CarlDominicA/247-575-SH-PLANIFICATION-DE-PROJET-BUS-CAN/README.md

## Ce projet est un module CAN pour une voiture de course de type électrique

#### ci-dessous, une affiche pour le présentoir

ImageStaticAffiche_CapteurCAN
