CarlDominicA/247-575-SH-PLANIFICATION-DE-PROJET-BUS-CAN/Session_H24/README.md

**Regroupe les travaux fait pendant la session d'hivers de 2024**

# Logiciel :
**contient tous les éléments logiciels/programmations de ce projet**

-envoie de trame CAN

-conversion analogique

# Matériel : 
**contient tous les éléments physique de ce projet.**

-PCB

-Liste capteurs

-Liste pièces
