CarlDominicA/247-575-SH-PLANIFICATION-DE-PROJET-BUS-CAN/Session_A23/README.md

**Regroupe les travaux fait pendant la session d'automne de 2023**

# Logiciel :
**contient tous les éléments logiciels/programmations de ce projet**

-envoie de trame CAN

-réception de trame CAN

-apperçu de la construction d'une trame

# Matériel : 
**contient tous les éléments physique de ce projet.**

-Prototype
