CarlDominicA/247-575-SH-PLANIFICATION-DE-PROJET-BUS-CAN/Session_H24/Logiciel/README.md

## ESP32Arduino
code : arduino (c++)
framework : platformino
description : envoie can sur en c++

## MCP3221
code : arduino (c++)
framework : platformino
description : conversion analogique à nunérique
