CarlDominicA/247-575-SH-PLANIFICATION-DE-PROJET-BUS-CAN/Session_H24/Matériel/README.md

## Matériaux pour le produit final

##### Boitier 3D (fait sur Tinkercad)

##### Capteurs (liste des capteurs du client 0-5v)

##### Liste d'achat (liste de pièces qui n'était pas en stock) *ne contient pas toutes les pièces

##### PCB (fait sur kicad)
