CarlDominicA/247-575-SH-PLANIFICATION-DE-PROJET-BUS-CAN/Session_A23/Matériel/README.md

## Listes de pièces à la conception du prototype

##### Breadbord/plaque de développement
##### ESP32-C3-Devkit
##### Potentiomètre (simuler un capteur 0-5v)
##### TJA1051T

## module intérégré dans le devkit (esp32)

##### module adc (conversion analogique à numérique)
##### module twai (conversion vers un signal CAN)
