CarlDominicA/247-575-SH-PLANIFICATION-DE-PROJET-BUS-CAN/Session_H24/Matériel/Capteurs/README.md

# Capteurs 0-5V automobile
download
