CarlDominicA/247-575-SH-PLANIFICATION-DE-PROJET-BUS-CAN/Session_H24/Matériel/PCB/README.md

# PCB
framework : kicad 7.0

CapturePCB
