CarlDominicA/247-575-SH-PLANIFICATION-DE-PROJET-BUS-CAN/Session_A23/Logiciel/README.md

**Ce projet est basé sur le esp32-C3 sur un workspace platformIO IDE pour Visual Studio Code**

## Pour Commencer

Ces instructions vous guideront pour configurer votre projet PlatformIO en utilisant Visual Studio Code.

### Prérequis

Vous devez avoir Visual Studio Code installé sur votre machine.

### Installation

**Installer l'extension PlatformIO** : Ouvrez Visual Studio Code, allez dans Extensions (Ctrl+Shift+X), recherchez "PlatformIO IDE", et installez-le.
