CarlDominicA/247-575-SH-PLANIFICATION-DE-PROJET-BUS-CAN/Session_H24/Matériel/PCB/BOM_Formule_SAE_ModuleCAN.xlsx

Bill of Material
Board | Module_CAN |  | Concepteur Principal |  | Carl-Dominic Aubin |  |  | 1 | 00
Cours | Projet_Fin_DEC |  | Date du projet |  | 2024-03-01
Département | Technologies du génie électrique |  | Date de génération du BOM |  | 3/1/2024
Révision | 1.00 |  | Heure de génération du BOM |  | 10:55 AM
Nombre de PCB | 1 |  | Variant |  | None
Item Number | Designator | Layer | Description | Comment | #Column Name Error:' Package / Case | #Column Name Error:' Supplier 1 | #Column Name Error:' Supplier Part Number 1 | Quantity | Quantity Total | #Column Name Error:' Note
1 | C16 | Top | CAP ALUM 100UF 20% 50V SMD | 100 uF |  |  |  |  | 0
2 | C1, C5, C6, C15 | Top/Bot | Chip Capacitor, 10 uF, +/- 10%, 50 V, -55 to 125 degC, 0603 (1608 Metric), RoHS, Tape and Reel | 10 uF |  |  |  |  | 0
3 | C14 | Top | Conductive Polymer Aluminum Solid Capacitors (OS-CON) 68uF ±20% 50V RADIAL SMT 10x12.6mm | 68 uF |  |  |  |  | 0
4 | C12, C13 | Top | Capacitor; Ceramic; Cap; 47.0pF; Tol 5%; SMT; Vol-Rtg 50V; C0G; Tape and Reel | 47 pF |  |  |  |  | 0
5 | C3, C7, C8, C9, C10, C11 | Top/Bot | CAP CER 0.01UF 50V X7R 0805 | 0,1 uF |  |  |  |  | 0
6 | C7, C8 | Top | CAP CER 100PF 50V C0G/NPO 0805 | 100 pF |  |  |  |  | 0
7 | D1 | Top | DIODE SCHOTTKY 40V 1A SOD123F | SS14FL |  |  |  |  | 0
8 | FB1 | Bot | 120 Ohms @ 100 MHz 1 Power Line Ferrite Bead 0603 (1608 Metric) 3A 30mOhm | BLM18KG121TZ1D |  |  |  |  | 0
9 | J1, J2, J3 | Top | Connector_PinSocket_2.54mm:PinSocket_1x04_P2.54mm_Vertical | Conn_01x04_Socket |  |  |  |  | 0
10 | L1 | Top | Inductor Power Unshielded Wirewound 47uH 20% 100KHz 1.8A 0.14Ohm DCR T/R | NPI31W470MTRF |  |  |  |  | 0
11 | R1 | Top | Thin Film Resistors - SMD CPF 0805 91R 0.1% 25PPM 1K RL | 91 OMHS |  |  |  |  | 0
12 | R2 | Top | Thin Film Resistors - SMD CPF 0805 150R 0.1% 25PPM 1K RL | 150 OMHS |  |  |  |  | 0
13 | R3 | Top | Thin Film Resistors - SMD CPF 0805 150R 0.1% 25PPM 1K RL | 330 OMHS |  |  |  |  | 0
14 | R4, R5, R6, R8, R9 | Top/Bot | Thin Film Resistors - SMD CPF 0805 4700R 0.1% 25PPM 1K RL | 4700 OMHS |  |  |  |  | 0
15 | R7 | Top | Thin Film Resistors - SMD CPF 0805 10 000R 0.1% 25PPM 1K RL | 10 000 OMHS |  |  |  |  | 0
16 | R10, R11 | Top | Thin Film Resistors - SMD CPF 0805 10R 0.1% 25PPM 1K RL | 10 OMHS |  |  |  |  | 0
17 | R12 | Top | Thin Film Resistors - SMD CPF 0805 120 0.1% 25PPM 1K RL | 120 OMHS |  |  |  |  | 0
18 | U1 | Bot | adc | MCP3221 |  |  |  |  | 0
19 | U2 | Top | level-shifter | TCA9517 |  |  |  |  | 0
20 | U3 | Bot | esp32microcontroller | XIAO ESP32C3 |  |  |  |  | 0
21 | U6 | Bot | can transceiver | TJA1051T |  |  |  |  | 0
22 | U7 | Bot | 5v regulator | LM2674M-5.0 |  |  |  |  | 0
23 | U5 | Top | 3.3v regulator | LM117 |  |  |  |  | 0
Commentaires ou instruction spécialies
