CarlDominicA/247-575-SH-PLANIFICATION-DE-PROJET-BUS-CAN/Session_H24/Matériel/Liste d'achat/demande achat CAN module.xlsx

Titre du projet
Formule SAE CAN (UdeS)
Demandeur(s) : Prof responsabe et étudiants
Carl-Dominic Aubin
Moment où le matériel est NÉCESSAIRE
Le plutôt possible
Identification des cours qui sont impactés
247-69P-SH
Lien(s) vers document de soumission (si applicable)
-
Liste des éléments associés
Description | Prix unitaire | Taux change (1 par défaut $Can) | Quantité demandée | Total item | Fournisseur | # Modèle pour commande | Hyperlien pour commande (si disponible) ou soumission | Commentaires et/ou autres informations | Colonne réservée pour suivi des commandes
MCP3221 | $2.770 | 1.00 | 10 | $27.70 | mouser | 579-MCP3221A5T-E/OT | https://www.mouser.ca/ProductDetail/Microchip-Technology/MCP3221A5T-E-OT?qs=InakTnyiSK9lljladcdZHQ%3D%3D&mgh=1 | adc i2c
TCA9517 | $1.567 | 1.00 | 10 | $15.67 | digikey | TCA9517DGKR | https://www.digikey.ca/en/products/detail/texas-instruments/TCA9517DGKR/4135104 | level shifter
TJA1051T | $2.140 | 1.00 | 10 | $21.40 | digikey | TJA1051T/E | https://www.digikey.ca/en/products/detail/nxp-usa-inc./TJA1051T%2FE,118/2803571?productid=2803571&gad_source=1 | can transceiver
Seeed Studio XIAO ESP32C3 | $4.200 | 1.00 | 10 | $42.00 |  | - | https://www.seeedstudio.com/Seeed-XIAO-ESP32C3-p-5431.html
Connecteur CAN 4 pins | $2.610 | 1.00 | 16 | $41.76 | digikey | 889-1479-ND | https://www.digikey.ca/en/products/detail/amphenol-sine-systems-corp/ATM04-4P/5227552
Connecteur CAN 3 pins | $2.350 | 1.00 | 8 | $18.80 | digikey | 889-1478-ND | https://www.digikey.ca/en/products/detail/amphenol-sine-systems-corp/ATM04-3P/5227551
condensateur 100uF | $1.192 | 1.00 | 10 | $11.92 | digikey | EEE-FH1H101L | https://www.digikey.ca/en/products/detail/panasonic-electronic-components/EEE-FH1H101L/20372560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
condensateur 68uF | $0.682 | 1.00 | 10 | $6.82 | digikey | EEE-FN1H680XP | https://www.digikey.ca/en/products/detail/panasonic-electronic-components/EEE-FN1H680XP/11656970
bobine 47 uH | $0.495 | 1.00 | 10 | $4.95 | arrow | NPI31W470MTRF | https://www.arrow.com/en/products/npi31w470mtrf/nic-components
diode ss14fl | $0.234 | 1.00 | 10 | $2.34 | digikey | 1N5819W | https://www.digikey.ca/en/products/detail/smc-diode-solutions/1N5819W/15964243 | original part is discontinued this is replacement
lm2674 | $4.817 | 1.00 | 10 | $48.17 | digikey | LM2674MX-5.0/NOPB | https://www.digikey.ca/en/products/detail/texas-instruments/LM2674MX-5-0-NOPB/366903
 |  | 1.00 |  | $0.00
 |  | 1.00 |  | $0.00
 |  |  | Total sans taxes | $64.77
 |  |  | Taxe 7% | $4.53
 |  |  | Total avec taxes | $69.30
 | : pièces ajoutées
