CarlDominicA/247-575-SH-PLANIFICATION-DE-PROJET-BUS-CAN/Session_H24/Matériel/Boitier 3D/Botier3D (1).stl

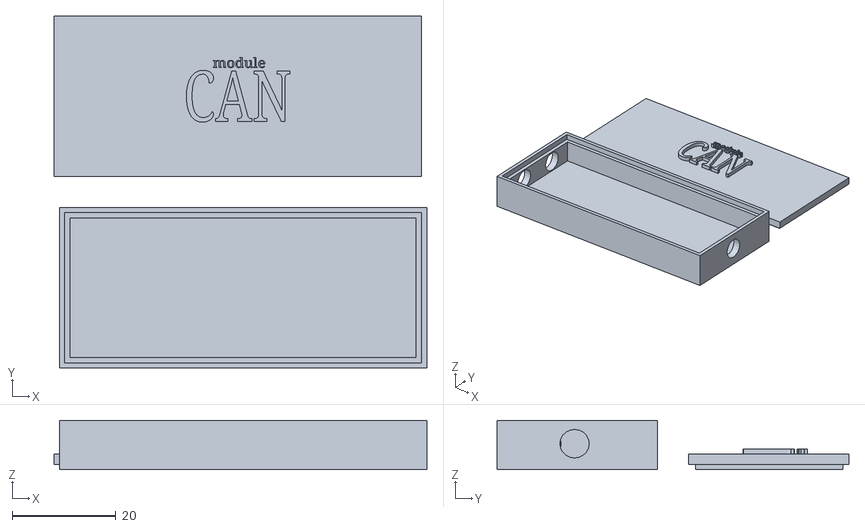
[picture p1: CAD file, 2024-03-20]
Session_H24/Matériel/Boitier 3D/Botier3D (1).stl
72.0 x 68.0 x 9.50
