CarlDominicA/247-575-SH-PLANIFICATION-DE-PROJET-BUS-CAN/Session_H24/Matériel/PCB/lib kicad/LIB_1N5819HWQ-7-F/1N5819HWQ-7-F/3D/1N5819HWQ-7-F.stp

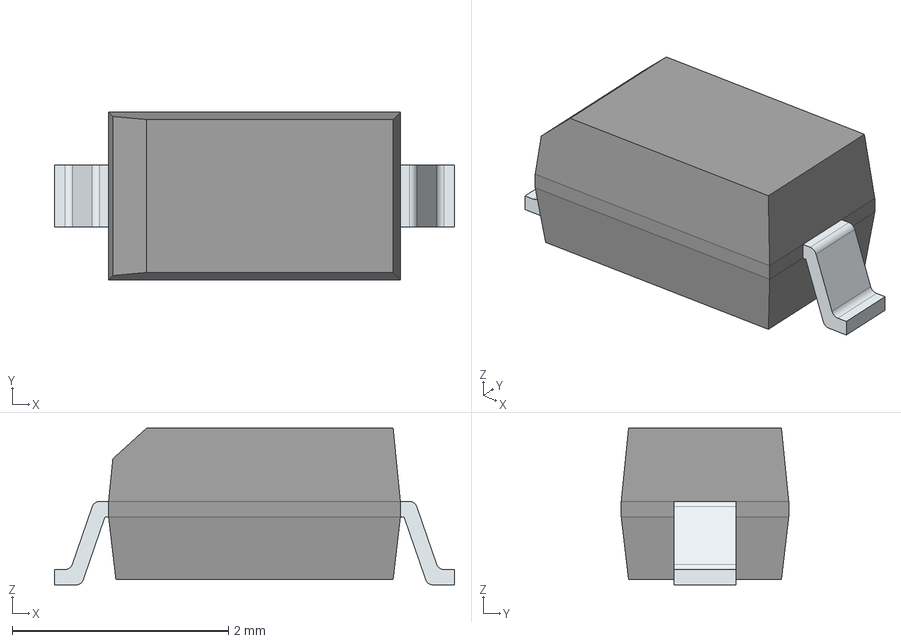
[picture p2: CAD file, 2024-03-13]
Session_H24/Matériel/PCB/lib kicad/LIB_1N5819HWQ-7-F/1N5819HWQ-7-F/3D/1N5819HWQ-7-F.stp
3.70 x 1.55 x 1.45 mm
FilletPinL
FilletPinR
