CarlDominicA/247-575-SH-PLANIFICATION-DE-PROJET-BUS-CAN/Session_H24/Matériel/PCB/lib kicad/LIB_BLM18KG121TZ1D/BLM18KG121TZ1D/3D/BLM18KG121TZ1D.stp

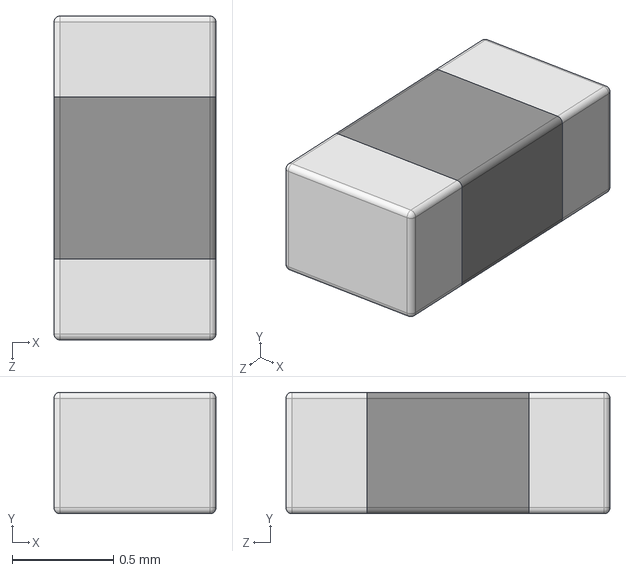
[picture p3: CAD file, 2024-03-13]
Session_H24/Matériel/PCB/lib kicad/LIB_BLM18KG121TZ1D/BLM18KG121TZ1D/3D/BLM18KG121TZ1D.stp
0.8 x 0.6 x 1.60 mm
