CarlDominicA/247-575-SH-PLANIFICATION-DE-PROJET-BUS-CAN/Session_H24/Matériel/PCB/lib kicad/LIB_EEEFH1H101L/EEEFH1H101L/3D/EEEFH1H101L.stp

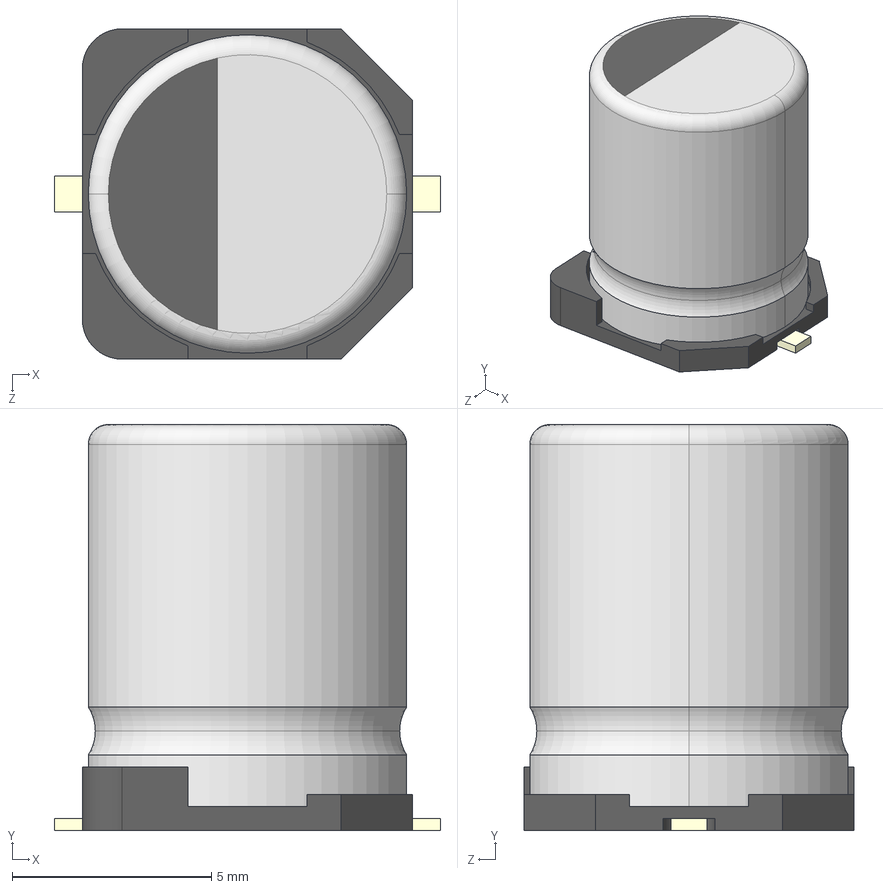
[picture p4: CAD file, 2024-03-13]
Session_H24/Matériel/PCB/lib kicad/LIB_EEEFH1H101L/EEEFH1H101L/3D/EEEFH1H101L.stp
9.70 x 10.2 x 8.30 mm
標準SIZE CODE F-001
標準SIZE CODE F-002
標準SIZE CODE F-003 x 2
