CarlDominicA/247-575-SH-PLANIFICATION-DE-PROJET-BUS-CAN/(list of files, cad)

Other CAD files:
Session_H24/Matériel/PCB/lib kicad/LIB_1N5819HWQ-7-F/1N5819HWQ-7-F/Allegro/sod3716x145n.psm
Session_H24/Matériel/PCB/lib kicad/LIB_1N5819HWQ-7-F/1N5819HWQ-7-F/DEHDL/1n5819hwq_7_f/chips/chips.prt
Session_H24/Matériel/PCB/lib kicad/LIB_ATM13-3P-BM04/ATM13-3P-BM04/Allegro/atm133pbm04.psm
Session_H24/Matériel/PCB/lib kicad/LIB_ATM13-3P-BM04/ATM13-3P-BM04/DEHDL/atm13_3p_bm04/chips/chips.prt
Session_H24/Matériel/PCB/lib kicad/LIB_ATM13-4P-BM02/ATM13-4P-BM02/Allegro/atm134pbm02.psm
Session_H24/Matériel/PCB/lib kicad/LIB_ATM13-4P-BM02/ATM13-4P-BM02/DEHDL/atm13_4p_bm02/chips/chips.prt
Session_H24/Matériel/PCB/lib kicad/LIB_BLM18KG121TZ1D/BLM18KG121TZ1D/Allegro/blm18kg101th1d.psm
Session_H24/Matériel/PCB/lib kicad/LIB_BLM18KG121TZ1D/BLM18KG121TZ1D/DEHDL/blm18kg121tz1d/chips/chips.prt
Session_H24/Matériel/PCB/lib kicad/LIB_EEEFH1H101L/EEEFH1H101L/Allegro/eeetc1v470p.psm
Session_H24/Matériel/PCB/lib kicad/LIB_EEEFH1H101L/EEEFH1H101L/DEHDL/eeefh1h101l/chips/chips.prt
