CarlDominicA/247-575-SH-PLANIFICATION-DE-PROJET-BUS-CAN/(list of files, drawings)

Other design files:
Session_H24/Matériel/PCB/lib kicad/LIB_1N5819HWQ-7-F/1N5819HWQ-7-F/Altium/1N5819HWQ-7-F.SchLib
Session_H24/Matériel/PCB/lib kicad/LIB_1N5819HWQ-7-F/1N5819HWQ-7-F/Altium/SOD3716X145N.PcbLib
Session_H24/Matériel/PCB/lib kicad/LIB_ATM13-4P-BM02/ATM13-4P-BM02/Altium/ATM13-4P-BM02.SchLib
Session_H24/Matériel/PCB/lib kicad/LIB_ATM13-4P-BM02/ATM13-4P-BM02/Altium/ATM134PBM02.PcbLib
Session_H24/Matériel/PCB/lib kicad/LIB_BLM18KG121TZ1D/BLM18KG121TZ1D/Altium/BLM18EG101TH1D.PcbLib
Session_H24/Matériel/PCB/lib kicad/LIB_BLM18KG121TZ1D/BLM18KG121TZ1D/Altium/BLM18KG121TZ1D.SchLib
