CarlDominicA/247-575-SH-PLANIFICATION-DE-PROJET-BUS-CAN/Session_H24/Matériel/PCB/Shémas.kicad_pcb

## KiCad design Session_H24/Matériel/PCB/Shémas.kicad_pcb (2024-03-13)

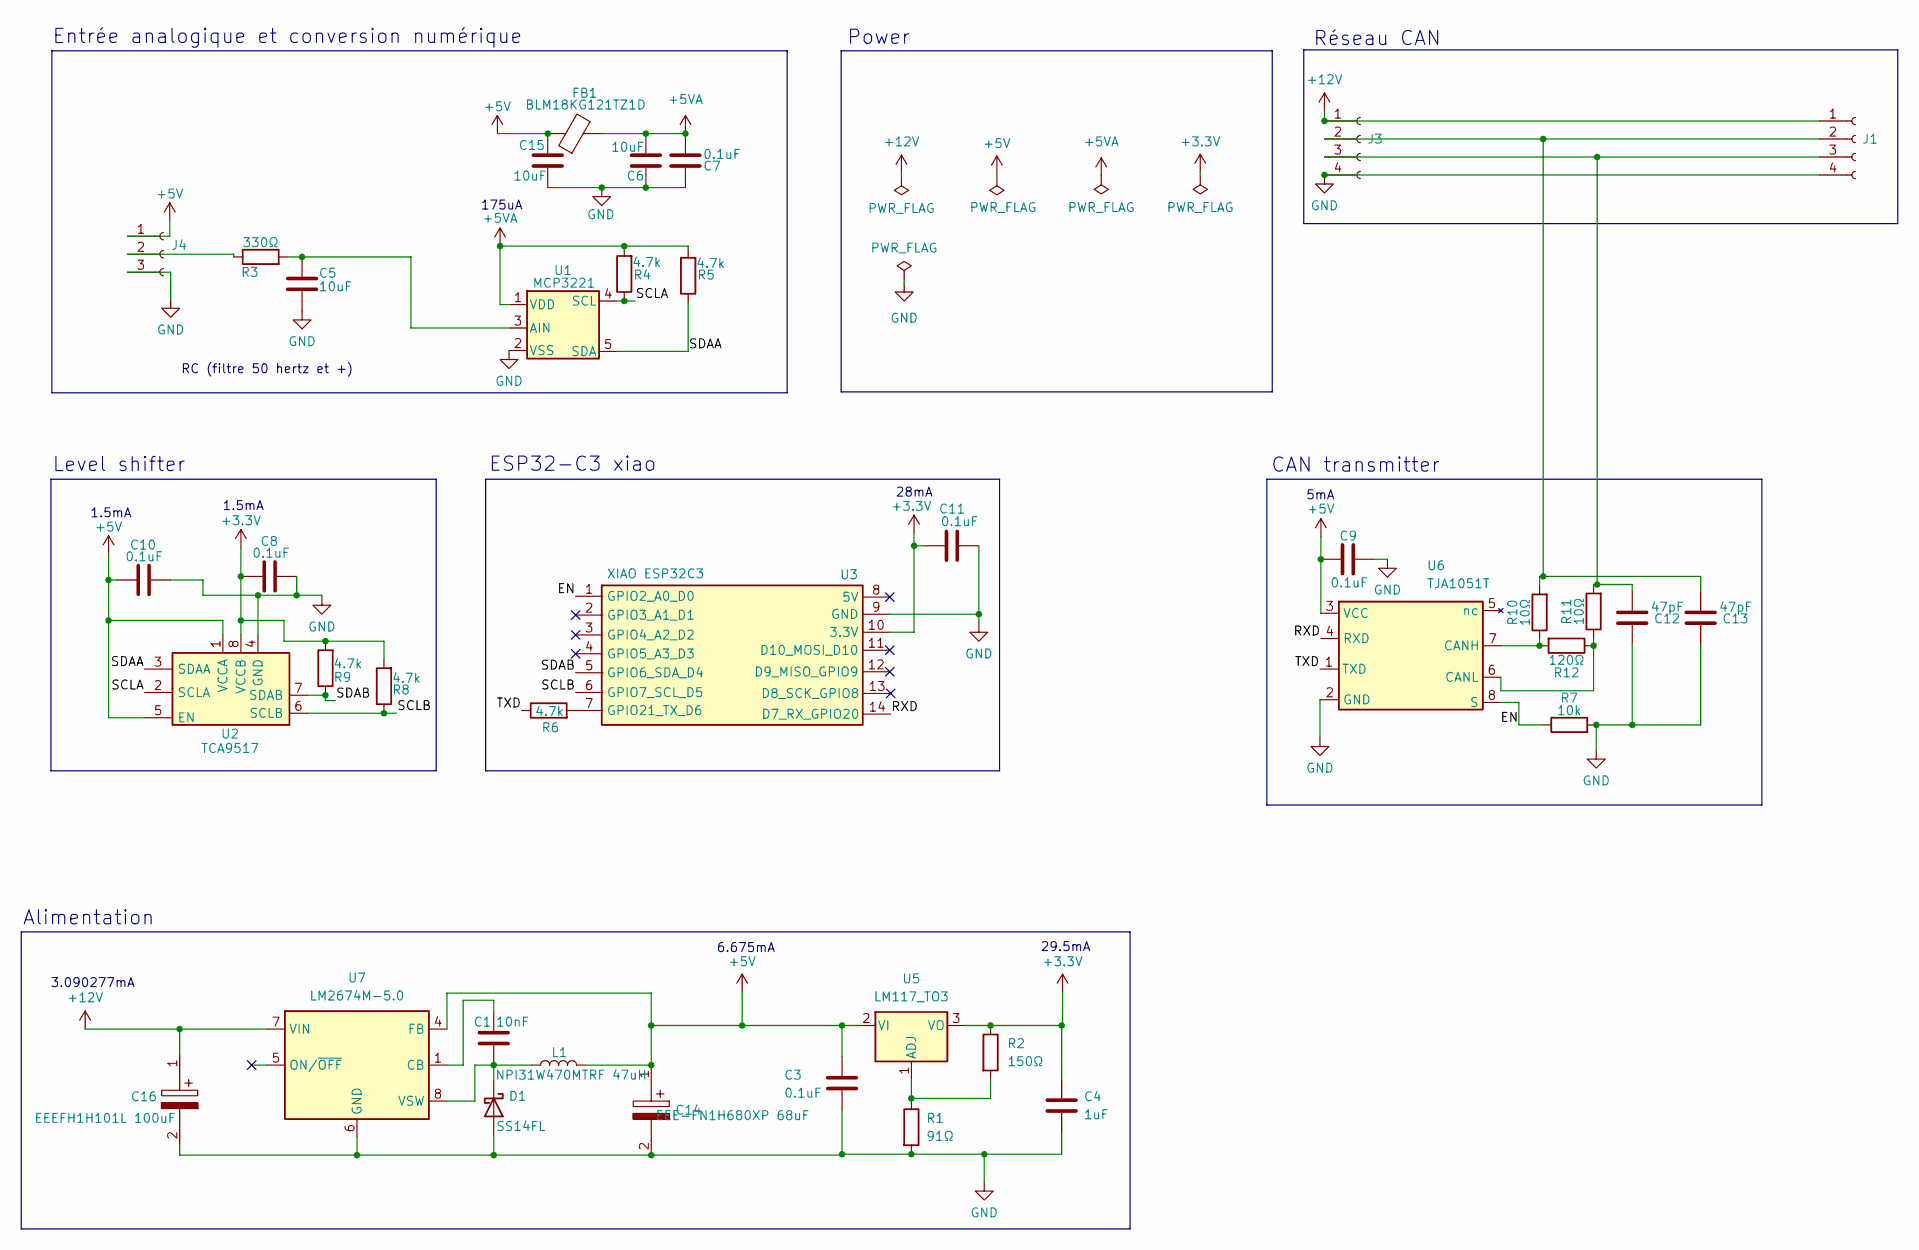
[picture p5: schematic Shémas.kicad_sch, Formule SAE module CAN SCH]

Parts:
C1: 10nF; C_0805_2012Metric_Pad1.18x1.45mm_HandSolder
C3, C7, C8, C9, C10, C11: 0.1uF; C_0805_2012Metric_Pad1.18x1.45mm_HandSolder
C4: 1uF; C_0805_2012Metric_Pad1.18x1.45mm_HandSolder
C5, C6, C15: 10uF; C_0805_2012Metric_Pad1.18x1.45mm_HandSolder
C12, C13: 47pF; C_0805_2012Metric_Pad1.18x1.45mm_HandSolder
C14: EEE-FN1H680XP 68uF; CP_Elec_8x6.9; Manufacturer_Part_Number EEEFH1H101L
C16: EEEFH1H101L 100uF; EEETC1V470P; Manufacturer_Part_Number EEEFH1H101L
D1: SS14FL; D_SOD-123F
FB1: BLM18KG121TZ1D; C_0603_1608Metric
J1, J3: Conn_01x04_Socket; PinSocket_1x04_P2.54mm_Vertical
J4: Conn_01x03_Socket; PinSocket_1x03_P2.54mm_Vertical
L1: NPI31W470MTRF 47uH; L_Bourns-SRR1005
R1: 91Ω; C_0805_2012Metric_Pad1.18x1.45mm_HandSolder
R2: 150Ω; C_0805_2012Metric_Pad1.18x1.45mm_HandSolder
R3: 330Ω; C_0805_2012Metric_Pad1.18x1.45mm_HandSolder
R4, R5, R6, R8, R9: 4.7k; C_0805_2012Metric_Pad1.18x1.45mm_HandSolder
R7: 10k; C_0805_2012Metric_Pad1.18x1.45mm_HandSolder
R10, R11: 10Ω; C_0805_2012Metric_Pad1.18x1.45mm_HandSolder
R12: 120Ω; C_0805_2012Metric_Pad1.18x1.45mm_HandSolder
U1: MCP3221; TSOT-23-5
U2: TCA9517; SOIC-8_3.9x4.9mm_P1.27mm
U3: XIAO ESP32C3; xiao esp32-c3
U5: LM117_TO3; SOT-223-3_TabPin2
U6: TJA1051T; SOIC-8_3.9x4.9mm_P1.27mm
U7: LM2674M-5.0; SOIC-8_3.9x4.9mm_P1.27mm

Connections:
+3.3V: C4.1, C8.2, C11.2, R2.1, R8.2, R9.2, U2.8 (VCCB), U3.10 (3.3V), U5.3 (VO)
+5V: C3.1, C9.1, C10.2, C14.1, C15.1, FB1.1, J4.1, L1.2, U2.1 (VCCA), U2.5 (EN), U5.2 (VI), U6.3 (VCC), U7.4 (FB)
+5VA: C6.2, C7.1, FB1.2, R4.2, R5.2, U1.1 (VDD)
+12V: C16.1, J1.1, J3.1, U7.7 (VIN)
/EN: R7.1, U3.1 (GPIO2_A0_D0), U6.8 (S)
/RXD: U3.14 (D7_RX_GPIO20), U6.4 (RXD)
/SCLA: R4.1, U1.4 (SCL), U2.2 (SCLA)
/SCLB: R8.1, U2.6 (SCLB), U3.6 (GPIO7_SCL_D5)
/SDAA: R5.1, U1.5 (SDA), U2.3 (SDAA)
/SDAB: R9.1, U2.7 (SDAB), U3.5 (GPIO6_SDA_D4)
/TXD: R6.1, U6.1 (TXD)
GND: C3.2, C4.2, C5.2, C6.1, C7.2, C8.1, C9.2, C10.1, C11.1, C12.1, C13.1, C14.2, C15.2, C16.2, D1.2 (A), J1.4, J3.4, J4.3, R1.2, R7.2, U1.2 (VSS), U2.4 (GND), U3.9 (GND), U6.2 (GND), U7.6 (GND)
unnamed: C1.1, D1.1 (K), L1.1, U7.8 (VSW)
unnamed: C13.2, J1.2, J3.2, R10.2
unnamed: C12.2, J1.3, J3.3, R11.2
unnamed: J4.2, R3.1
unnamed: C5.1, R3.2, U1.3 (AIN)
unnamed: R6.2, U3.7 (GPIO21_TX_D6)
unnamed: R1.1, R2.2, U5.1 (ADJ)
unnamed: R10.1, R12.2, U6.7 (CANH)
unnamed: R11.1, R12.1, U6.6 (CANL)
unnamed: C1.2, U7.1 (CB)

Notes on the sheet:
6.675mA
3.090277mA
1.5mA
Alimentation
29.5mA
Power
Entrée analogique et conversion numérique
ESP32-C3 xiao
RC (filtre 50 hertz et +)
Réseau CAN
Level shifter
28mA
CAN transmitter
5mA
175uA

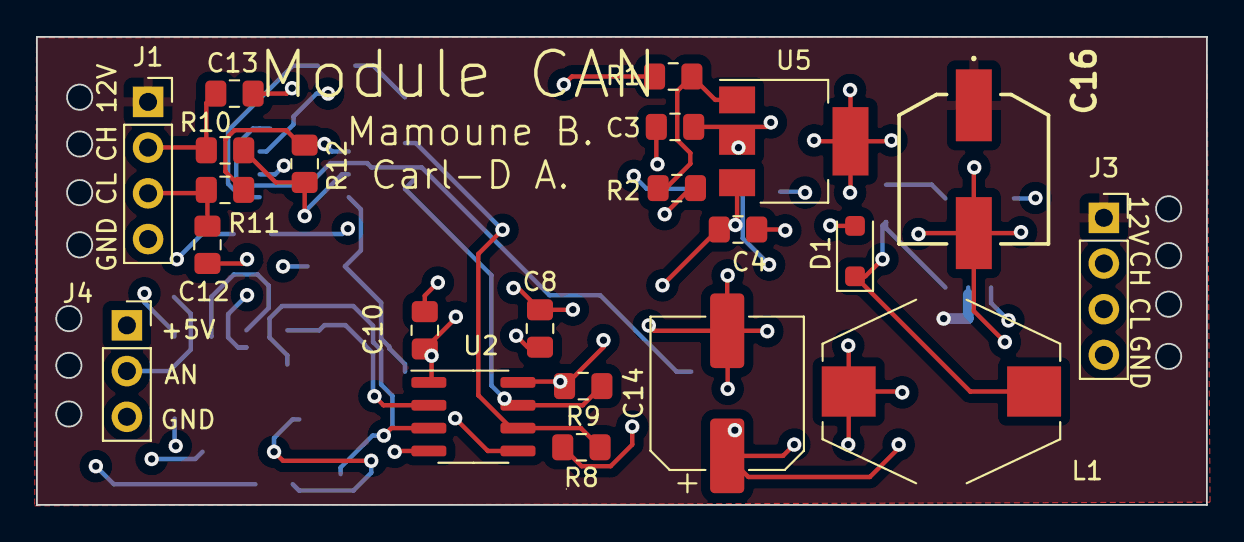
[picture p6: board Shémas.kicad_pcb from above]

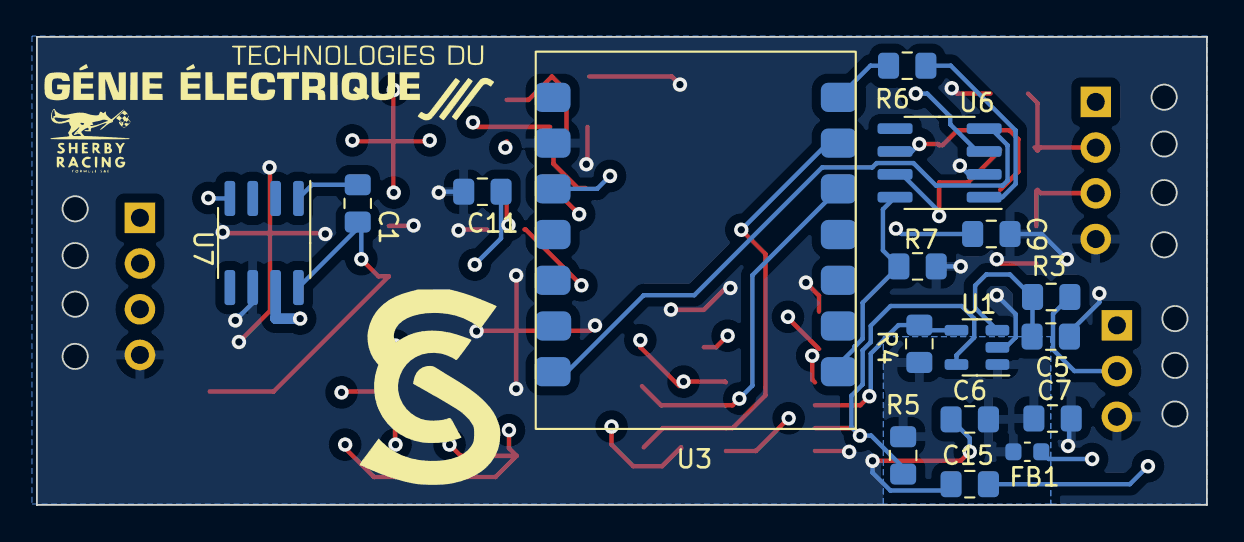
[picture p7: board Shémas.kicad_pcb from below]

Board: 4 copper layers, 65.0 x 26.0 mm, 39 parts (17 on the bottom side), 22 nets.
