CarlDominicA/247-575-SH-PLANIFICATION-DE-PROJET-BUS-CAN/(commit log)

2024-03-13 Modification branches
    Changment pour fichiers
    [BOM_Formule_SAE_ModuleCAN.xlsx, Liste des capteurs.xlsx, Shémas.kicad_pcb, Shémas.kicad_sch, demande achat CAN module 2.xlsx, demande achat CAN module.xlsx]
2024-03-13 structure
    restruture du git
    [1N5819HWQ-7-F.SchLib, 1N5819HWQ-7-F.stp, ATM13-4P-BM02.SchLib, ATM134PBM02.PcbLib, BLM18EG101TH1D.PcbLib, BLM18KG121TZ1D.SchLib, BLM18KG121TZ1D.stp, EDI2CAP.CFG]
2024-03-13 Mise à jour de l'entete de fichier
    Ajout de l'auteur, la date et le matériel.
2024-03-15 Mise à jour du fichier main.cpp du dossier MCP3221
    Mise à jour de l'entête du fichier
2024-03-15 Téléversement du dossier MCP3221 2.0
    Mise à jour 2.0:
    Modification des entête de fichier
2024-03-15 Téléversement du dossier Esp32Arduino 2.0
    Suppression des fichiers en trop
2024-03-18 changement au boitier
    modification boitier 3d
    [Botier3D.stl]
2024-03-18 Create Botier3D (1).stl
    [Botier3D (1).stl]
2024-03-18 ok
    ok
    [Botier3D.stl]
2024-03-20 Revert "Merge branch 'main' of https://github.com/CarlDominicA/Projet_Module_CAN"
    This reverts commit 115457697176f41481bb26a3a492d3f1f2c8b880, reversing
    changes made to 382dd95bcc57aa367b2ea9962602b4170ec6f6f6.
    [Botier3D (1).stl]
2024-03-22 mise à jour fichier
    Ajout des ID dans main.cpp
    Nettoyage fichier Esp32Arduino
2024-04-15 Mise à jour du code principale
    - changement des GPIOs pour PCB
    - changement de délai pour envoi
    - changement de board pour ESP32-C3 XIAO
2024-04-19 Mise à jour code Esp32Arduino et MCP3221
    ArduinoEsp32:
    - Ajout README.md
    - changement dans Plateformio.ini
    MCP3221:
    - ajout de README.md
2024-04-22 Mise à jour main.cpp 4.0
    - ajout de readme.md
    - changement format message CAN
    - ajout de DecimalID.h pour choix de l'ID
2024-04-22 mise à jour de README.md
